ojousima/as-03200/README

This repository serves files of an Aalto university project.
It is meant for internal use of our team, but feel free to poke around.

We're happy to address any questions and comments.
