ojousima/as-03200/doc/Time_usage.ods

 | Otso | Johan | Aleksi
3 | 6 | 3 | 5
4 | 14 | 3 | 10
5 | 20 | 3 | 10
6 | 17 | 0 | 6
7 | 5 | 0 | 5
8 | 10 | 0 | 4
9 | 4 | 0 | 4
10 | 4 | 7 | 4
11 | 3 | 0 | 0
12 | 0 | 2 | 0
13 | 1 | 0 | 3
14 | 4 | 3 | 4
15 | 0 | 0 | 0
16 | 0 | 0 | 0
17 | 2 | 0 | 3
18 | 2 | 16 | 3
19 | 10 | 17 | 5
20 | 3 | 4 | 3
21 | 2 | 20 | 3
 | 107 | 78 | 72
