ojousima/as-03200/simulations/ltc6803_battery_interface.asc

C1: cap; 3µ3
C2: cap; 3µ3
C3: cap; 3µ3
C4: cap; 100n
D1: LED; NSSW008CT-P1
D2: LED; NSSW008CT-P1
D3: LED; NSSW008CT-P1
D4: zener; BZX84C6V2L
D5: zener; BZX84C6V2L
D6: zener; BZX84C6V2L
D7: zener; 1N5371B
L1: FerriteBead
Q1: pnp; 2N2907
Q2: pnp; 2N2907
Q3: pnp; 2N2907
R1: res; 10k
R2: res; 10k
R3: res; 10k
R4: res; 10k
R5: res; 100
R6: res; 10k
R7: res; 10k
R8: res; 100
R9: res; 100
R10: res; 1meg
R11: res; 1meg
R12: res; 20
R13: res; 1meg
R14: res; 20
R15: res; 1meg
R16: res; 10k
R17: res; 100
R18: res; 100
V1: voltage; 4.2
V2: voltage; 4.2
V3: voltage; 4.2
Named nets: 0, 12+, VDD, DGND
.tran 0 10m 0
Pull-up on
Discharging
GND behind
large resistance
Discharge
current path
Optional
status LED
Protection Zener
C1
C0
S1
S2
C2
S3
C4
3+
2+
1+
1-
