ojousima/as-03200/simulations/ltc6803_passive_discharge_returnpathfail.asc

C1: cap
C2: cap
Q1: pnp
Q2: pnp
R1: res
R2: res
R3: res
R4: res
V1: voltage
V2: voltage
V3: voltage
Named nets: 0, Uout
Incorrectly returned current.
Uout = V2 + V3 * (R1/(R1+R2))
Correctly returned current.
Uout = V2
