ojousima/as-03200/pcb/monitor.kicad_pcb

## KiCad design pcb/monitor.kicad_pcb (2014-05-05)

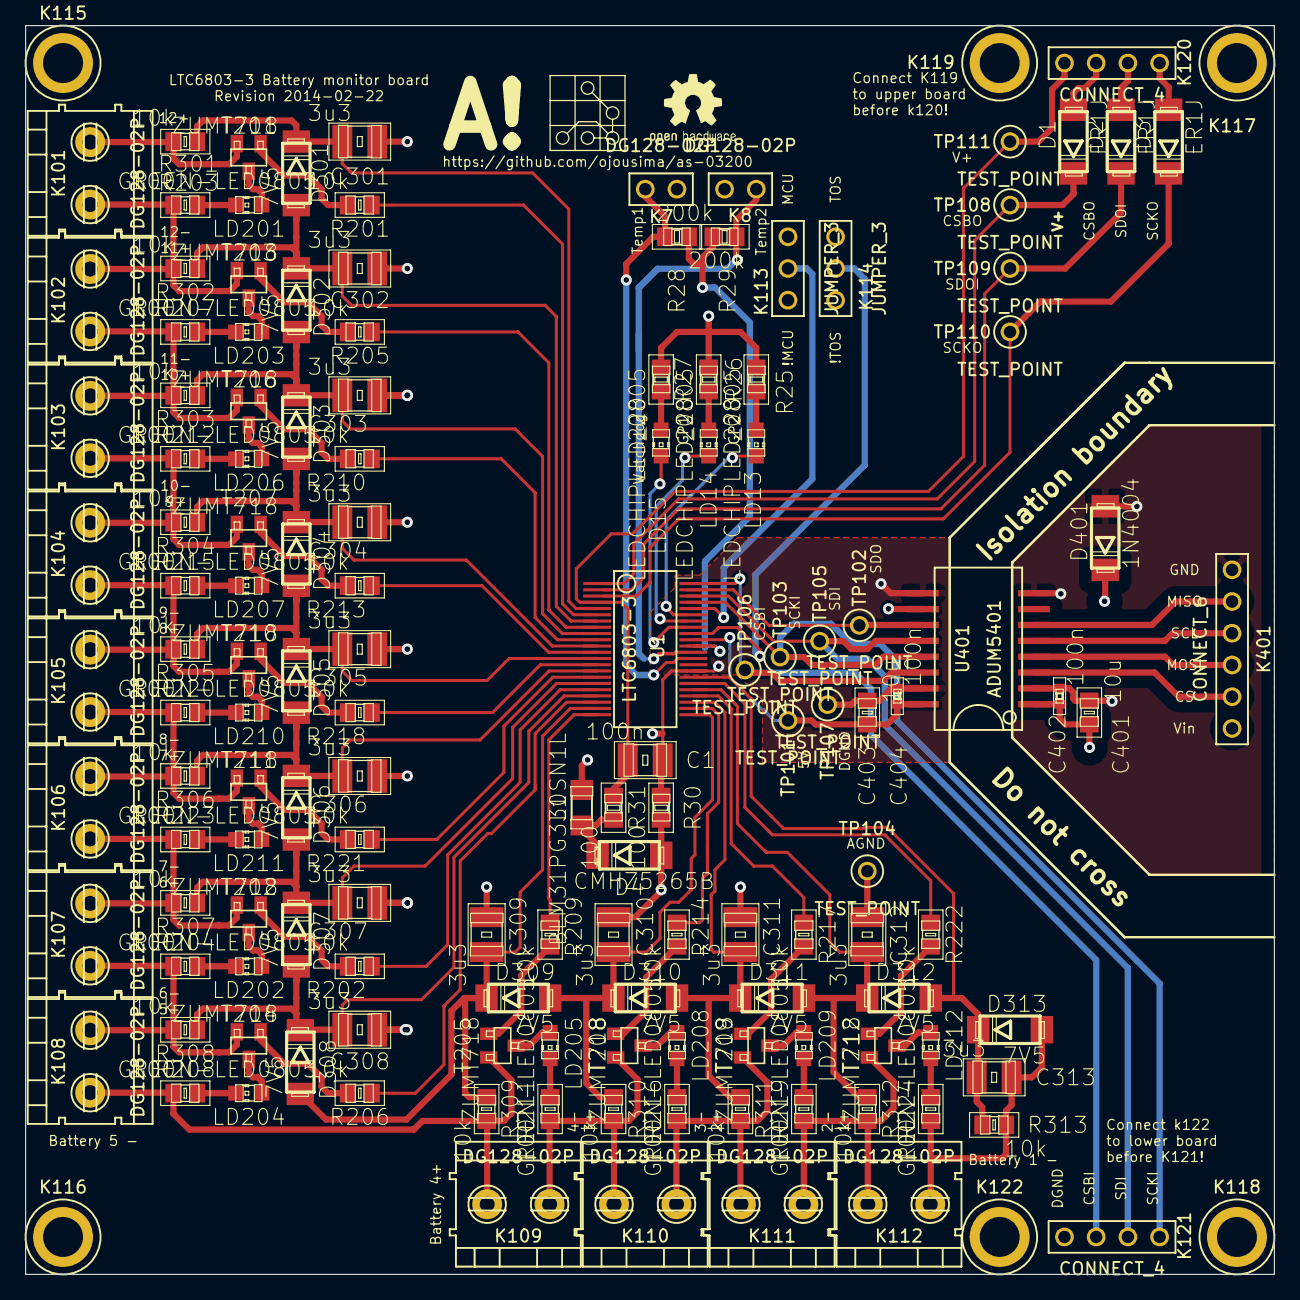
[picture p9: board monitor.kicad_pcb from above]

Board: 4 copper layers, 100.0 x 100.0 mm, 146 parts (0 on the bottom side), 105 nets.

Parts:
C1: 100n; rcl-C1210
C301, C302, C303, C304, C305, C306, C307, C308, C309, C310, C311, C312, C313: 3u3; rcl-C1210
C401, C403: 10u; rcl-C0805
C402, C404: 100n; rcl-C0402
D1, D2, D3: ER1J; diode-1-DO214AA
D4: CMHZ5265B; diode-1-DO214AA
D301, D302, D303, D304, D305, D306, D307, D308, D309, D310, D311, D312, D313: 7V5; diode-1-DO214AA
D401: 1N4004; diode-1-DO214AA
K7, K8: DG128-02P; CONNECT_2_2mm54_VERT
K101, K102, K103, K104, K105, K106, K107, K108, K109, K110, K111, K112: DG128-02P; CONNECT_2_5.00mm_SCREW_DG128-02P_DG128-5.0-02P-14-00A(H)
K113, K114: JUMPER_3; JUMPER_3_2.54mm
K115, K116, K117, K118, K119, K122: MOUNT; M3_MOUNT_BARE
K120, K121: CONNECT_4; 2_54_MM_HEADER_4
K401: CONNECT_6; 2_54_MM_HEADER_6
L1: BLM31PG330SN1L; rcl-L1206
LD13, LD14, LD15: LEDCHIPLED_0805; led-CHIP-LED0805
LD201, LD202, LD203, LD204, LD205, LD206, LD207, LD208, LD209, LD210, LD211, LD212: GREEN-LED0805; led-CHIP-LED0805
R25, R26, R27: 220; rcl-R0805
R28, R29: 200k; rcl-R0805
R30, R31: 100; rcl-R0805
R201, R202, R205, R206, R209, R210, R213, R214, R217, R218, R221, R222, R301, R302, R303, R304, R305, R306, R307, R308, R309, R310, R311, R312, R313: 10k; rcl-C0805
R203, R204, R207, R208, R211, R212, R215, R216, R219, R220, R223, R224: 100; rcl-C0805
T201, T202, T203, T204, T205, T206, T207, T208, T209, T210, T211, T212: ZUMT718; transistor-SOT23-BEC
TP101, TP102, TP103, TP104, TP105, TP106, TP107, TP108, TP109, TP110, TP111: TEST_POINT; Keystone_Electronics_5000
U1: LTC6803-3; SSOP44_HS
U401: ADUM5401; SOIC_16_WIDE

Connections:
/CSBO: D1.C, TP108.1, U1.1
/GPIO1: LD14.C, U1.38
/GPIO2: LD13.C, U1.39
/Isolation/5V: C403.1, C404.1, K113.3, K114.3, R25.1, R26.1, R27.1, TP101.1, U1.35, U401.10, U401.16
/Isolation/CS: K401.5, U401.3
/Isolation/CSBI: K121.2, TP106.1, U1.44, U401.14
/Isolation/GND1: C401.2, C402.2, D401.A, K401.1, U401.2, U401.8
/Isolation/MISO: K401.2, U401.6
/Isolation/MOSI: K401.4, U401.4
/Isolation/SCKI: K121.4, TP103.1, U1.41, U401.13
/Isolation/SCL: K401.3, U401.5
/Isolation/SDI: K121.3, TP105.1, U1.42, U401.12
/Isolation/SDO: TP102.1, U1.43, U401.11
/Isolation/Vin: C401.1, C402.1, D401.C, K401.6, U401.1
/Lowpass/BATT1+: K111.2, K112.1, R219.2, R312.2, T212.E
/Lowpass/BATT2+: K110.2, K111.1, R216.2, R311.2, T209.E
/Lowpass/BATT3+: K109.2, K110.1, R211.2, R310.2, T208.E
/Lowpass/BATT4+: K108.2, K109.1, R208.2, R309.2, T205.E
/Lowpass/BATT5+: K107.2, K108.1, R204.2, R308.2, T204.E
/Lowpass/BATT6+: K106.2, K107.1, R223.2, R307.2, T202.E
/Lowpass/BATT7+: K105.2, K106.1, R220.2, R306.2, T211.E
/Lowpass/BATT8+: K104.2, K105.1, R215.2, R305.2, T210.E
/Lowpass/BATT9+: K103.2, K104.1, R212.2, R304.2, T207.E
/Lowpass/BATT10+: K102.2, K103.1, R207.2, R303.2, T206.E
/Lowpass/BATT11+: K101.2, K102.1, R203.2, R302.2, T203.E
/Lowpass/C0: C313.2, D312.A, D313.C, R313.1, U1.29
/Lowpass/C1: C312.2, D311.A, D312.C, R312.1, U1.27
/Lowpass/C2: C311.2, D310.A, D311.C, R311.1, U1.25
/Lowpass/C3: C310.2, D309.A, D310.C, R310.1, U1.23
/Lowpass/C4: C309.2, D308.A, D309.C, R309.1, U1.21
/Lowpass/C5: C308.2, D307.A, D308.C, R308.1, U1.19
/Lowpass/C6: C307.2, D306.A, D307.C, R307.1, U1.17
/Lowpass/C7: C306.2, D305.A, D306.C, R306.1, U1.15
/Lowpass/C8: C305.2, D304.A, D305.C, R305.1, U1.13
/Lowpass/C9: C304.2, D303.A, D304.C, R304.1, U1.11
/Lowpass/C10: C303.2, D302.A, D303.C, R303.1, U1.9
/Lowpass/C11: C302.2, D301.A, D302.C, R302.1, U1.7
/Lowpass/C12: C301.2, D301.C, R301.1, U1.5
/SCKO: D3.C, TP110.1, U1.3
/SDOI: D2.C, TP109.1, U1.2
/TOS: K114.2, U1.36
/V+: C1.2, K120.1, R31.1, TP111.1, U1.4
/VMODE: K113.2, U1.40
/Vref: R28.2, R29.2, U1.34
/Vtemp1: K7.2, R28.1, U1.32
/Vtemp2: K8.1, R29.1, U1.33
/WDTB: LD15.C, U1.37
/discharge/BATT12+: K101.1, K119.1, L1.1, R301.2, T201.E
/discharge/S1: R222.1, U1.28
/discharge/S2: R217.1, U1.26
/discharge/S3: R214.1, U1.24
/discharge/S4: R209.1, U1.22
/discharge/S5: R206.1, U1.20
/discharge/S6: R202.1, U1.18
/discharge/S7: R221.1, U1.16
/discharge/S8: R218.1, U1.14
/discharge/S9: R213.1, U1.12
/discharge/S10: R210.1, U1.10
/discharge/S11: R205.1, U1.8
/discharge/S12: R201.1, U1.6
AGND: C301.1, C302.1, C303.1, C304.1, C305.1, C306.1, C307.1, C308.1, C309.1, C310.1, C311.1, C312.1, C313.1, D4.A, D313.A, K112.2, K122.1, R30.2, R224.2, R313.2, TP104.1
DGND: C1.1, C403.2, C404.2, K7.1, K8.2, K113.1, K114.1, K121.1, R30.1, TP107.1, U1.30, U401.9, U401.15
unnamed: D1.A, K120.2
unnamed: D2.A, K120.3
unnamed: D3.A, K120.4
unnamed: D4.C, L1.2, R31.2
unnamed: LD13.A, R25.2
unnamed: LD14.A, R26.2
unnamed: LD15.A, R27.2
unnamed: LD201.A, T201.C
unnamed: LD201.C, R203.1
unnamed: LD202.A, T202.C
unnamed: LD202.C, R204.1
unnamed: LD203.A, T203.C
unnamed: LD203.C, R207.1
unnamed: LD204.A, T204.C
unnamed: LD204.C, R208.1
unnamed: LD205.A, T205.C
unnamed: LD205.C, R211.1
unnamed: LD206.A, T206.C
unnamed: LD206.C, R212.1
unnamed: LD207.A, T207.C
unnamed: LD207.C, R215.1
unnamed: LD208.A, T208.C
unnamed: LD208.C, R216.1
unnamed: LD209.A, T209.C
unnamed: LD209.C, R219.1
unnamed: LD210.A, T210.C
unnamed: LD210.C, R220.1
unnamed: LD211.A, T211.C
unnamed: LD211.C, R223.1
unnamed: LD212.A, T212.C
unnamed: LD212.C, R224.1
unnamed: R201.2, T201.B
unnamed: R202.2, T202.B
unnamed: R205.2, T203.B
unnamed: R206.2, T204.B
unnamed: R209.2, T205.B
unnamed: R210.2, T206.B
unnamed: R213.2, T207.B
unnamed: R214.2, T208.B
unnamed: R217.2, T209.B
unnamed: R218.2, T210.B
unnamed: R221.2, T211.B
unnamed: R222.2, T212.B
