ojousima/as-03200/(commit log)

2014-01-26 Barebones of the project
    [monitor.kicad_pcb, monitor.sch]
2014-01-29 Updated files for newer version of kicad
    [monitor.kicad_pcb, monitor.sch]
2014-01-30 Added serial ports to schema
    [monitor.sch]
2014-01-30 Added few footprints, matched components for footprints
    [monitor.kicad_pcb, monitor.sch]
2014-01-30 Switched a few pins, added NC pin
2014-01-30 Changed connectors to screw terminals
    [monitor.sch]
2014-01-30 Switched a few nets for routing
    [monitor.sch]
2014-01-30 Enlargened board
    [monitor.kicad_pcb]
2014-01-31 Added documentation for monitor PCB
2014-01-31 Matched schematic with design document
    [monitor.sch]
2014-01-31 Matched pcb with schematic
    [monitor.kicad_pcb]
2014-02-02 Add missing connections to schema
    [monitor.sch]
2014-02-02 Switch ground connection
    [monitor.sch]
2014-02-02 Change to 4 layer design
    [monitor.kicad_pcb, monitor.sch]
2014-02-02 Add temperature + led connections
    [monitor.kicad_pcb]
2014-02-05 Move LPF and discharge to subcircuits
    [discharge.sch, lowpass.sch, monitor.sch]
2014-02-05 Add isolation to MCU comms
    [discharge.sch, lowpass.sch, monitor.sch]
2014-02-07 Add isolation to schema
    [discharge.sch, isolation.sch, lowpass.sch]
2014-02-08 Add symbol and footprint for test point
2014-02-08 Add testpoints to schema
    [isolation.sch, monitor.sch]
2014-02-08 Place grounds to PCB
    [monitor.kicad_pcb]
2014-02-09 Named temp sensor connectors
    [monitor.sch]
2014-02-09 Remove groundplanes
    [monitor.kicad_pcb]
2014-02-09 Fix missing junction
    [discharge.sch]
2014-02-09 Battery connections
    [monitor.kicad_pcb]
2014-02-09 More connections
    [monitor.kicad_pcb]
2014-02-09 Add temperature connections
    [discharge.sch, isolation.sch, lowpass.sch, monitor.kicad_pcb, monitor.sch]
2014-02-09 Fixed few missing junctions in schematic
    [discharge.sch, isolation.sch, lowpass.sch, monitor.sch]
2014-02-09 First DRC-ok draft
    [monitor.kicad_pcb]
2014-02-15 Add pinheaders, mounting hole
2014-02-15 Change some connectors to 2.54 mm
    [isolation.sch, monitor.sch]
2014-02-15 Implement changes
    [monitor.kicad_pcb]
2014-02-22 Finishing touches
    [monitor.kicad_pcb]
2014-02-22 Add logos
    [monitor.kicad_pcb]
2014-04-03 MC: First implementation: Debug data from Monitor
    Microcontroller can read diagnostics data from monitor card over SPI bus
2014-04-29 SPI code commenting
2014-05-01 Fixed PEC calculation bug.
    [pec.ino]
2014-05-02 Added read/write configuration register functions.
    Functions non-working, need debugging. Only frame for future.
2014-05-03 SW: Fixed functions reading/modifying monitor registers
    - Added functions modifying configuration register
    - Improved debugging messages
    [Microcontroller.ino, main.ino, pec.ino, spi_io.ino]
2014-05-04 SW: Added printWord debug function
2014-05-04 SW: Fixed SPI_readAllVoltages()
    - 12-bit voltage values stored properly in 16-bit variables.
    [spi_io.ino]
2014-05-04 SW: Removed SPI general receive buffer. Obsolete.
2014-05-04 SW: Init LED sequence and handle user input to main.
2014-05-04 SW: Added local conf register. Removed debug prints.
    - Separated local and monitor conf register.
    --- Monitor register can be polled every cycle/loop.
    - Remove a lot of obsolete debugging prints.
    - Added print register functions for debugging.
2014-05-04 SW: User can specifically print debug data.
2014-05-05 SW: Changed voltage unsigned -> signed.
2014-05-05 SW: Bug fix. Improved debug messages.
    - Fixed bug in setting comparator duty cycle.
    - Improved debug when sending commands to microcontroller.
    [handleInput.ino]
2014-05-05 SW: Added printing usage instructions.
2014-05-05 SW: Style fix to debug printing.
    [spi_io.ino]
2014-05-05 First production version
    [monitor.kicad_pcb]
2014-05-05 Match components with footprint
    [discharge.sch]
2014-05-06 SW: Add discharge support for Battery Cells 0-3
2014-05-07 SW: Toggle adc conversion. Improved usage instructions.
2014-05-07 SW: Bugfix: Error messages won't flood serial output.
    [Microcontroller.ino, handleInput.ino, main.ino, spi_io.ino]
2014-05-11 SW: Added support for up to 12 cells. Split functions.
    - 12 cells can be discharged
    - Functions printing debug messages split into separate instances.
2014-05-22 SW: loop_ctr reset to 1, not 0.
    [main.ino]
2014-05-22 SW: Fixed arduino crash problem/bug.
    - Added F() wrapper to Serial.print calls.
    [handleInput.ino, spi_io.ino]
2014-05-22 Update doc to match first prototype
2014-05-22 Fix mistakes found in first prototype
    [discharge.sch, isolation.sch, lowpass.sch, monitor.sch]
2014-05-24 Fix signal labels
    [isolation.sch]
2014-05-24 Doc: Add hw communication, battery interface and power supply
2014-05-25 SW: Moved debug prints to separate file
2014-05-25 Doc: Added time usage spreadsheet
    [Time_usage.ods]
